floodsense/sensor_experiments/reports/README.md

# FloodSense project sensor experiment reports
