floodsense/sensor_experiments/notebooks/README.md

# FloodSense project sensor experiment analysis notebooks
