floodsense/sensor_experiments/src/README.md

# FloodSense project sensor experiment source code
