floodsense/sensor_experiments/src/mcu/README.md

# FloodSense project sensor experiment MCU source code
