floodsense/sensor_experiments/src/misc/README.md

# FloodSense project sensor experiment misc source code
