floodsense/sensor_experiments/src/misc/bme/README.md

**Connections for bme 280 and adafruit Feather M0**
  - Connect Vcc and Gnd
  - Connect SCK pin to pin 13 on board
  - Connect MISO pin to pin 9 on board
  - Connect MOSI pin to pin 11 on board
  - Connect CS pin to pin 10 on board
