floodsense/sensor_experiments/img/HRXL-MaxSonar-Family.jpg

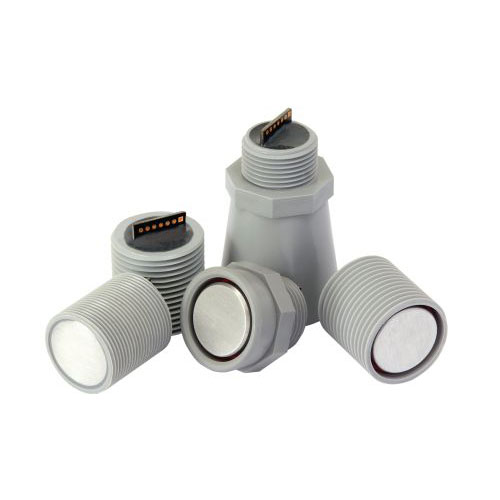
img/HRXL-MaxSonar-Family.jpg
