floodsense/sensor_experiments/testing/Lora-with-Maxbotix_BatteryLevel/README.md

This file reads Maxbotix and Battery level and sends a packet periodically.
The periodicity of transmission is controlled by TX_INTERVAL, which is set to 300 in this example and further, the MCU is idle between the uplinks.
