floodsense/sensor_experiments/testing/README.md

This folder consists of all different tests with code and corresponding readme file
