floodsense/sensor_experiments/testing/Lora_optimizations/README.md

This folder consists of different lora optimizations, methods and their readmes
