floodsense/sensor_experiments/(threads)

Thread 4 (2020-08-25):

SD card LoRa session info save/load

cmydlarz, 2020-08-25:
Integrate code for SD card LoRa session data write. Heres the first pass just so its safe, but its untested and unfinshed! I didnt get around to storing the longer session key type info.

```
/*******************************************************************************
   Copyright (c) 2015 Thomas Telkamp and Matthijs Kooijman
   Copyright (c) 2018 Terry Moore, MCCI

   Permission is hereby granted, free of charge, to anyone
   obtaining a copy of this document and accompanying files,
   to do whatever they want with them without any restriction,
   including, but not limited to, copying, modification and redistribution.
   NO WARRANTY OF ANY KIND IS PROVIDED.

   This example sends a valid LoRaWAN packet with payload "Hello,
   world!", using frequency and encryption settings matching those of
   the The Things Network. It's pre-configured for the Adafruit
   Feather M0 LoRa.

   This uses OTAA (Over-the-air activation), where where a DevEUI and
   application key is configured, which are used in an over-the-air
   activation procedure where a DevAddr and session keys are
   assigned/generated for use with all further communication.

   Note: LoRaWAN per sub-band duty-cycle limitation is enforced (1% in
   g1, 0.1% in g2), but not the TTN fair usage policy (which is probably
   violated by this sketch when left running for longer)!
   To use this sketch, first register your application and device with
   the things network, to set or generate an AppEUI, DevEUI and AppKey.
   Multiple devices can use the same AppEUI, but each device has its own
   DevEUI and AppKey.

   Do not forget to define the radio type correctly in
   arduino-lmic/project_config/lmic_project_config.h or from your BOARDS.txt.

 *******************************************************************************/
#include <lmic.h>
#include <hal/hal.h>
#include <SPI.h>
#include <SD.h>
#include <Adafruit_SleepyDog.h>

#define DISABLE_PING
#define DISABLE_BEACONS

// Pin definitions
#define VBATPIN A7

#define cardSelect 10
#define readPin 11
#define triggerPin 12

File lorawanSessionStore;

// This EUI must be in little-endian format, so least-significant-byte
// first. When copying an EUI from ttnctl output, this means to reverse
// the bytes. For TTN issued EUIs the last bytes should be 0xD5, 0xB3,
// 0x70.
static const u1_t PROGMEM APPEUI[8] = {<INSERT>};
void os_getArtEui (u1_t* buf) {
  memcpy_P(buf, APPEUI, 8);
}
// This should also be in little endian format, see above.
static const u1_t PROGMEM DEVEUI[8] = {<INSERT>};
void os_getDevEui (u1_t* buf) {
  memcpy_P(buf, DEVEUI, 8);
}
// This key should be in big endian format (or, since it is not really a
// number but a block of memory, endianness does not really apply). In
// practice, a key taken from the TTN console can be copied as-is.
static const u1_t PROGMEM APPKEY[16] = {<INSERT>};
void os_getDevKey (u1_t* buf) {
  memcpy_P(buf, APPKEY, 16);
}
//static uint8_t mydata[] = "Hello, world!";
static osjob_t sendjob;
// Schedule TX every this many seconds (might become longer due to duty
// cycle limitations).
const unsigned TX_INTERVAL = 1;
// Pin mapping
//
// Adafruit BSPs are not consistent -- m0 express defs ARDUINO_SAMD_FEATHER_M0,
// m0 defs ADAFRUIT_FEATHER_M0
//
#if defined(ARDUINO_SAMD_FEATHER_M0) || defined(ADAFRUIT_FEATHER_M0)
// Pin mapping for Adafruit Feather M0 LoRa, etc.
const lmic_pinmap lmic_pins = {
  .nss = 8,
  .rxtx = LMIC_UNUSED_PIN,
  .rst = 4,
  .dio = {3, 6, LMIC_UNUSED_PIN},
  .rxtx_rx_active = 0,
  .rssi_cal = 8,              // LBT cal for the Adafruit Feather M0 LoRa, in dB
  .spi_freq = 8000000,
};
#else
# error "Unknown target"
#endif

//https://jackgruber.github.io/2020-04-13-ESP32-DeepSleep-and-LoraWAN-OTAA-join/
const unsigned MAX_CHANNELS = 73;

u4_t LORAWAN_netid = 0;
devaddr_t LORAWAN_devaddr = 0;
u1_t LORAWAN_nwkKey[16];
u1_t LORAWAN_artKey[16];
u1_t LORAWAN_dn2Dr;
u1_t LORAWAN_dnConf;
u4_t LORAWAN_seqnoDn;
u4_t LORAWAN_seqnoUp = 0;
s1_t LORAWAN_adrTxPow;
s1_t LORAWAN_datarate;
u1_t LORAWAN_txChnl;
s2_t LORAWAN_adrAckReq;
u1_t LORAWAN_rx1DrOffset;
u1_t LORAWAN_rxDelay;
//u4_t LORAWAN_channelFreq[MAX_CHANNELS];
//u2_t LORAWAN_channelDrMap[MAX_CHANNELS];
//u4_t LORAWAN_channelDlFreq[MAX_CHANNELS];
//band_t LORAWAN_bands[MAX_BANDS];
//u2_t LORAWAN_channelMap;

//int sleep_loop_cnt = 2;
int sleep_loop_cnt = 7;

void onEvent (ev_t ev) {
  Serial.print(os_getTime());
  Serial.print(": ");
  switch (ev) {
    case EV_SCAN_TIMEOUT:
      Serial.println(F("EV_SCAN_TIMEOUT"));
      break;
    case EV_BEACON_FOUND:
      Serial.println(F("EV_BEACON_FOUND"));
      break;
    case EV_BEACON_MISSED:
      Serial.println(F("EV_BEACON_MISSED"));
      break;
    case EV_BEACON_TRACKED:
      Serial.println(F("EV_BEACON_TRACKED"));
      break;
    case EV_JOINING:
      Serial.println(F("EV_JOINING"));
      break;
    case EV_JOINED:
      Serial.println(F("EV_JOINED"));
      {
        u4_t netid = 0;
        devaddr_t devaddr = 0;
        u1_t nwkKey[16];
        u1_t artKey[16];
        LMIC_getSessionKeys(&netid, &devaddr, nwkKey, artKey);
        Serial.print("netid: ");
        Serial.println(netid, DEC);
        Serial.print("devaddr: ");
        Serial.println(devaddr, HEX);
        Serial.print("AppSKey: ");
        for (size_t i = 0; i < sizeof(artKey); ++i) {
          if (i != 0)
            Serial.print("-");
          printHex2(artKey[i]);
        }
        Serial.println("");
        Serial.print("NwkSKey: ");
        for (size_t i = 0; i < sizeof(nwkKey); ++i) {
          if (i != 0)
            Serial.print("-");
          printHex2(nwkKey[i]);
        }
        Serial.println();
      }

      LMICSaveVars();
      LMICLoadVars();

      // Disable link check validation (automatically enabled
      // during join, but because slow data rates change max TX
      // size, we don't use it in this example.
      LMIC_setLinkCheckMode(0);
      break;
    /*
      || This event is defined but not used in the code. No
      || point in wasting codespace on it.
      ||
      || case EV_RFU1:
      ||     Serial.println(F("EV_RFU1"));
      ||     break;
    */
    case EV_JOIN_FAILED:
      Serial.println(F("EV_JOIN_FAILED"));
      break;
    case EV_REJOIN_FAILED:
      Serial.println(F("EV_REJOIN_FAILED"));
      break;
      break;
    case EV_TXCOMPLETE:
      Serial.println(F("EV_TXCOMPLETE (includes waiting for RX windows)"));
      if (LMIC.txrxFlags & TXRX_ACK)
        Serial.println(F("Received ack"));
      if (LMIC.dataLen) {
        Serial.println(F("Received "));
        Serial.println(LMIC.dataLen);
        Serial.println(F(" bytes of payload"));
      }
      pinMode(13, OUTPUT);
      digitalWrite(13, LOW);

      delay(5000);
      // Schedule next transmission
      os_setTimedCallback(&sendjob, os_getTime() + 1, do_send);
      //os_setTimedCallback(&sendjob, os_getTime()+sec2osticks(TX_INTERVAL), do_send);
      break;
    case EV_LOST_TSYNC:
      Serial.println(F("EV_LOST_TSYNC"));
      break;
    case EV_RESET:
      Serial.println(F("EV_RESET"));
      break;
    case EV_RXCOMPLETE:
      // data received in ping slot
      Serial.println(F("EV_RXCOMPLETE"));
      break;
    case EV_LINK_DEAD:
      Serial.println(F("EV_LINK_DEAD"));
      break;
    case EV_LINK_ALIVE:
      Serial.println(F("EV_LINK_ALIVE"));
      break;
    /*
      || This event is defined but not used in the code. No
      || point in wasting codespace on it.
      ||
      || case EV_SCAN_FOUND:
      ||    Serial.println(F("EV_SCAN_FOUND"));
      ||    break;
    */
    case EV_TXSTART:
      Serial.println(F("EV_TXSTART"));
      break;
    case EV_TXCANCELED:
      Serial.println(F("EV_TXCANCELED"));
      break;
    case EV_RXSTART:
      /* do not print anything -- it wrecks timing */
      break;
    case EV_JOIN_TXCOMPLETE:
      Serial.println(F("EV_JOIN_TXCOMPLETE: no JoinAccept"));
      break;
    default:
      Serial.print(F("Unknown event: "));
      Serial.println((unsigned) ev);
      break;
  }
}

unsigned char mydata[4];
float measuredvbat;

void do_send(osjob_t* j) {

  pinMode(13, OUTPUT);
  digitalWrite(13, HIGH);
  // Check if there is not a current TX/RX job running
  if (LMIC.opmode & OP_TXRXPEND) {
    Serial.println(F("OP_TXRXPEND, not sending"));
  } else {
    // Prepare upstream data transmission at the next possible time.

    mydata[0] = 1;
    mydata[1] = 2;
    //mydata[2] = 3;
    //mydata[3] = 0;
    measuredvbat = analogRead(VBATPIN); //Float
    measuredvbat *= 2;    // we divided by 2, so multiply back
    measuredvbat *= 3.3;  // Multiply by 3.3V, our reference voltage
    measuredvbat /= 1024; // convert to voltage
    Serial.print("VBat: " ); Serial.println(measuredvbat);
    measuredvbat *= 1000; //make it milli volts to transmit
    Serial.print("VBat in mVolts: " ); Serial.println(measuredvbat);
    uint16_t batlevel = measuredvbat; //Payload
    byte lowbat = lowByte(batlevel);
    byte highbat = highByte(batlevel);
    mydata[2] = (unsigned char)lowbat; //we're unsigned
    mydata[3] = (unsigned char)highbat;

    //LMIC_setTxData2(1, mydata, sizeof(mydata)-1, 0);
    LMIC_sendWithCallback(1, mydata, sizeof(mydata), 0, send_callback, 0);
    Serial.println(F("Packet queued"));
  }
  // Next TX is scheduled after TX_COMPLETE event.
}

void send_callback(void *pUserData, int fSuccess)
{

  if (!fSuccess)
  {
    Serial.println(F("Send failure"));
  }
  else
  {
    Serial.println("Sent successful");
    // Do something
  }
}

void setup() {

  pinMode(13, OUTPUT);
  digitalWrite(13, HIGH);

  delay(5000);

  while (! Serial)
    ;
  Serial.begin(9600);
  Serial.println(F("Starting"));

  // LMIC init
  os_init();
  // Reset the MAC state. Session and pending data transfers will be discarded.
  LMIC_reset();
  // Disable link check validation (automatically enabled)
  LMIC_setLinkCheckMode(0);
  LMIC_setClockError(MAX_CLOCK_ERROR * 10 / 100);//https://www.thethingsnetwork.org/forum/t/need-help-with-mcci-lmic-and-ttn-join-wait-issue/30846
  LMIC_setDrTxpow(DR_SF7, 14);
  LMIC_selectSubBand(1);

  // Start job (sending automatically starts OTAA too)
  do_send(&sendjob);
  pinMode(13, OUTPUT);
  digitalWrite(13, LOW);
}
void loop() {
  os_runloop_once();
  //  USBDevice.detach();
  //      Sleep For a while (currently X mins) --> This controls duty cycle
  //      for (int i = 0; i < sleep_loop_cnt; i++) {
  //        Watchdog.sleep(8000);
  //      }
  //  delay(5000);
  //  USBDevice.init();
  //  USBDevice.attach();
}

void printHex2(unsigned v) {
  v &= 0xff;
  if (v < 16)
    Serial.print('0');
  Serial.print(v, HEX);
}

void printHex2File(File sdFile, unsigned v) {
  v &= 0xff;
  if (v < 16)
    sdFile.print('0');
  sdFile.print(v, HEX);
}

void LMICSaveVars()
{
  digitalWrite(8, HIGH);
  Serial.print("Initializing SD card...");

  if (!SD.begin(10)) {
    Serial.println("initialization failed!");
  } else {
    Serial.println("initialization done.");
    char filename[10];
    strcpy(filename, "/LMIC.TXT");

    lorawanSessionStore = SD.open(filename, O_WRITE | O_CREAT | O_TRUNC);
    lorawanSessionStore.seek(0);

    if (!lorawanSessionStore) {
      Serial.print("Error opening: ");
      Serial.println(filename);
    }

    LORAWAN_netid = LMIC.netid;
    lorawanSessionStore.print("netid="); lorawanSessionStore.println(LORAWAN_netid, DEC);

    LORAWAN_devaddr = LMIC.devaddr;
    lorawanSessionStore.print("devaddr="); lorawanSessionStore.println(LMIC.devaddr, HEX);

    memcpy(LORAWAN_nwkKey, LMIC.nwkKey, 16);
    lorawanSessionStore.print("nwkKey=");

    for (size_t i = 0; i < sizeof(LORAWAN_nwkKey); ++i) {
      printHex2File(lorawanSessionStore, LORAWAN_nwkKey[i]);
    }
    lorawanSessionStore.println();

    memcpy(LORAWAN_artKey, LMIC.artKey, 16);
    lorawanSessionStore.print("artKey=");

    for (size_t i = 0; i < sizeof(LORAWAN_artKey); ++i) {
      printHex2File(lorawanSessionStore, LORAWAN_artKey[i]);
    }
    lorawanSessionStore.println();

    LORAWAN_dn2Dr = LMIC.dn2Dr;
    lorawanSessionStore.print("dn2Dr="); lorawanSessionStore.println(LORAWAN_dn2Dr, DEC);

    LORAWAN_dnConf = LMIC.dnConf;
    lorawanSessionStore.print("dnConf="); lorawanSessionStore.println(LORAWAN_dnConf, DEC);

    LORAWAN_seqnoDn = LMIC.seqnoDn;
    lorawanSessionStore.print("seqnoDn="); lorawanSessionStore.println(LORAWAN_seqnoDn, DEC);

    LORAWAN_seqnoUp = LMIC.seqnoUp;
    lorawanSessionStore.print("seqnoUp="); lorawanSessionStore.println(LORAWAN_seqnoUp, DEC);

//    LORAWAN_adrTxPow = LMIC.adrTxPow;
//    lorawanSessionStore.print("adrTxPow="); lorawanSessionStore.println(LORAWAN_adrTxPow, DEC);
//
//    LORAWAN_datarate = LMIC.datarate;
//    lorawanSessionStore.print("datarate="); lorawanSessionStore.println(LORAWAN_datarate, DEC);

    LORAWAN_txChnl = LMIC.txChnl;
    lorawanSessionStore.print("txChnl="); lorawanSessionStore.println(LORAWAN_txChnl, DEC);

    LORAWAN_adrAckReq = LMIC.adrAckReq;
    lorawanSessionStore.print("adrAckReq="); lorawanSessionStore.println(LORAWAN_adrAckReq, DEC);

    LORAWAN_rx1DrOffset = LMIC.rx1DrOffset;
    lorawanSessionStore.print("rx1DrOffset="); lorawanSessionStore.println(LORAWAN_rx1DrOffset, DEC);

    LORAWAN_rxDelay = LMIC.rxDelay;
    lorawanSessionStore.print("rxDelay="); lorawanSessionStore.print(LORAWAN_rxDelay, DEC);

    //    memcpy(LORAWAN_channelFreq, LMIC.channelFreq, MAX_CHANNELS*sizeof(u4_t));
    //    memcpy(LORAWAN_channelDrMap, LMIC.channelDrMap, MAX_CHANNELS*sizeof(u2_t));
    //    memcpy(LORAWAN_channelDlFreq, LMIC.channelDlFreq, MAX_CHANNELS*sizeof(u4_t));
    //    memcpy(LORAWAN_bands, LMIC.bands, MAX_BANDS*sizeof(band_t));
    //    LORAWAN_channelMap = LMIC.channelMap;

    lorawanSessionStore.flush();
    lorawanSessionStore.close();
  }

  digitalWrite(8, LOW);

  Serial.println(F("Save LMIC parameters ..."));
}

void LMICLoadVars()
{
  digitalWrite(8, HIGH);
  Serial.println(F("Load LMIC parameters ..."));
  char filename[10];
  strcpy(filename, "/LMIC.TXT");
  lorawanSessionStore = SD.open(filename, FILE_READ);

  if (lorawanSessionStore) {

    while (lorawanSessionStore.available()){
      String line = lorawanSessionStore.readStringUntil('\r');
      char copy[50];
      char varStr[20];
      line.toCharArray(copy, 50);
      Serial.println(copy);
      char *token = strtok(copy, "=");
      strcpy(varStr, token);
      if(token) {
        token = strtok(NULL, "=");
        Serial.println(varStr);
        Serial.println(atoi(token));

        if(strcmp(varStr, "netid")) Serial.println(token);
        else if (strcmp(varStr, "devaddr")) Serial.println(token);
        else if (strcmp(varStr, "nwkKey")) Serial.println(token);
        else if (strcmp(varStr, "artKey")) Serial.println(token);
        else if (strcmp(varStr, "dn2Dr")) LMIC.dn2Dr = atoi(token);
        else if (strcmp(varStr, "dnConf")) LMIC.dnConf = atoi(token);
        else if (strcmp(varStr, "seqnoDn")) LMIC.seqnoDn = atoi(token);
        else if (strcmp(varStr, "seqnoUp")) LMIC_setSeqnoUp(atoi(token));
        else if (strcmp(varStr, "txChnl")) LMIC.txChnl = atoi(token);
        else if (strcmp(varStr, "adrAckReq")) LMIC.adrAckReq = atoi(token);
        else if (strcmp(varStr, "rx1DrOffset")) LMIC.rx1DrOffset = atoi(token);
        else if (strcmp(varStr, "rxDelay")) LMIC.rxDelay = atoi(token);
      }
    }

  } else {
    Serial.println("Error opening LMIC conf file");
  }

  lorawanSessionStore.close();

  digitalWrite(8, LOW);
}
```

Thread 5 (2020-09-14):

Duty Cycle with downlink

Praneethsvch, 2020-09-14:
Sending and receiving a downlink:

Downlink when sent on the TTN console>Applications>Device Overview, the downlink message is queued for the next upcoming RX window of the uplink for class A LoRa devices (i.e class A nodes downlinks can be only an answer to a node uplink more here: https://www.thethingsnetwork.org/forum/t/solved-how-to-initiate-downlink-message-to-ttn-console/26171/3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)

I successfully received a downlink by adding this snippet next to EV_TXCOMPLETE:

```
if (LMIC.dataLen)
{
      // data received in rx slot after tx
      Serial.print(F("Received "));
      Serial.print(LMIC.dataLen);
      Serial.print(F(" bytes of payload: 0x"));
      for (int i = 0; i < LMIC.dataLen; i++) {
         if (LMIC.frame[LMIC.dataBeg + i] < 0x10) {
              Serial.print(F("0"));
           }
         Serial.print(LMIC.frame[LMIC.dataBeg + i], HEX);
       }
      Serial.println();
      receive_downlink();
}
```

However the issue is this process is manual and need some trigger (automation) and need any advice or help on APIs, conditions and duty cycle params

Praneethsvch, 2020-09-14:
also to note, LMIC.frame[LMIC.dataBeg] to LMIC.frame[LMIC.dataBeg + LMIC.dataLen] contains the downlink message and the previous bits are piggybacked MAC data.

Praneethsvch, 2020-11-20:
addded new functionalities here: https://github.com/floodsense/floodsense_sensor/releases/tag/v1.1

Closed 2020-11-20.

Thread 6 (2020-09-28):

SD Card init and failure is blocking

Praneethsvch, 2020-09-28:
Further support for SD card is needed when it fails to open file to r/w and/or initialize SD Card midway the sensors life time. Right now if the SD card fails, it is blocking.

Praneethsvch, 2020-11-20:
added SD_ERROR flag which is unblocking

Closed 2020-11-20.

Thread 7 (2020-11-18):

AquaPlumb Testing

Praneethsvch, 2020-11-18:

cmydlarz, 2020-11-19:
Scaled down Aquaplumb ADC values and scaled to mm. Noise looks minimal and resolution seems good at the ~1mm level. The downward trend shows water evaporation over 30 hours resulting in a ~5mm drop in water depth. The calibration of each length of cable was slightly off which explains the slightly different gradients of the short (1m) and long (3m).

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
