floodsense/sensor_experiments/(commit log)

2020-06-08 Code for Interfacing Sensors
2020-06-08 Ultrasonic ReadME file with working, description, images and links
2020-07-10 Create FeatherM0Lora_Maxbotix_Batterylevel.ino
    Sketch to send Distance and Battery-level using OTAA using Feather LoRa M0
2020-07-27 Update Featherm0LoRa_OptimizedforLowPower.ino
    added Maxbotix sensor
2020-07-29 Update Featherm0LoRa_OptimizedforLowPower.ino
    pin initializations edit
2020-08-10 Update MB_7389-100.ino
    read pin - 11 and trigger pin - 12
2020-08-11 Update loggingMaxbotixontoSDcard.ino
    added writeToSDCard function which takes string as an argument and creates a new file every hard reset.
    [loggingMaxbotixontoSDcard.ino]
2020-08-11 Create sensormode5withSDCardlogging.ino
    sensormode:5 with SD card logging
2020-08-21 Create Lora-with-Maxbotix_BatteryLevel.ino
    basic lora with maxbotix and battery level
2020-08-21 Create Ultrasonic_Sensor_Modes_withLoRa.ino
    5 sensor mode without sd card logging
2020-08-21 Create Ultrasonic_Sensor_Modes_withLoRa_SDCardlogging.ino
    logging every event to sd card
2020-09-02 Rename testing/Critical Jobs/sensormode5withCriticalJobs.ino to testing/Critical_Jobs/sensormode5withCriticalJobs.ino
    rename
2020-09-23 Create lowpower_sdfat_mb_lora_with_TT8M1.ino
    This code:
    - Uses TT8M1 to completely turn off the sensor using signal from pin 5
    acheiving 95uAmps current while deepsleep after EV_TXCOMPLETE
    - Further testing needed on SD card support and timing and accuracy of
    ultrasonic measurements.
2020-09-25 updated us sensor img
2020-11-02 Update Technical-Documentation.md
    updated BOM
2020-11-16 simple aquaplumb sensor read
2021-07-21 improved and error free
    [free-run-mode-MB7389.ino]
